MeshiShachaf/4th-Order-Control-System---beam-balancing-/README.md

# 4th Order Control System - Beam Balancing

Compilation of files for a 4th order nested control system for balancing a ball on a beam at specified positions. PID controller is the primary implemented control law.

## Authors

- Meshi Shachaf
- Daniel E. Licht (lichtphyz@gmail.com)
