MeshiShachaf/4th-Order-Control-System---beam-balancing-/coin_bucket.3mf

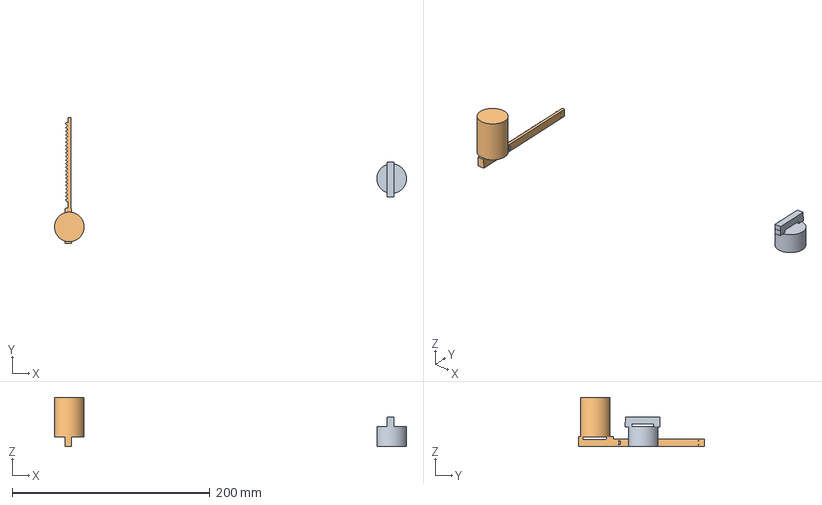
[picture p17: CAD file, 2026-04-17]
coin_bucket.3mf
356.2 x 128.0 x 49.8 mm
Shape-Cylinder
Merged
