MeshiShachaf/4th-Order-Control-System---beam-balancing-/(commit log)

2026-04-17 adding code
    here i am adding the code that was used to run this project. The code was implemented on a Arduino UNO and MEGA
2026-04-17 Create coin_bucket.3mf
    this is a 3d print file for manufacturing a rapid prototype
    [coin_bucket.3mf]
2026-04-18 Add files via upload
    Laser cutter file for cutting the frame of the beam
